Muthukumar-Ravichandran/Smart-locker-/IMG-20250516-WA0002(1).jpg

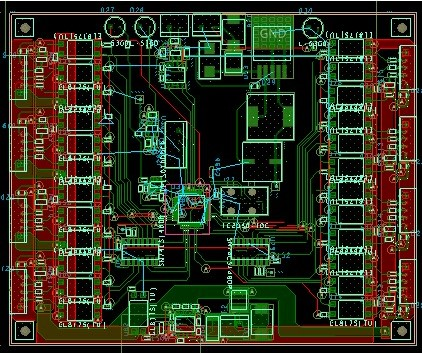
IMG-20250516-WA0002(1).jpg
