Muthukumar-Ravichandran/Smart-locker-/cock_lock.pdf

# STM32

CONTROLLER | 5V TO 3.3V CONVERTER

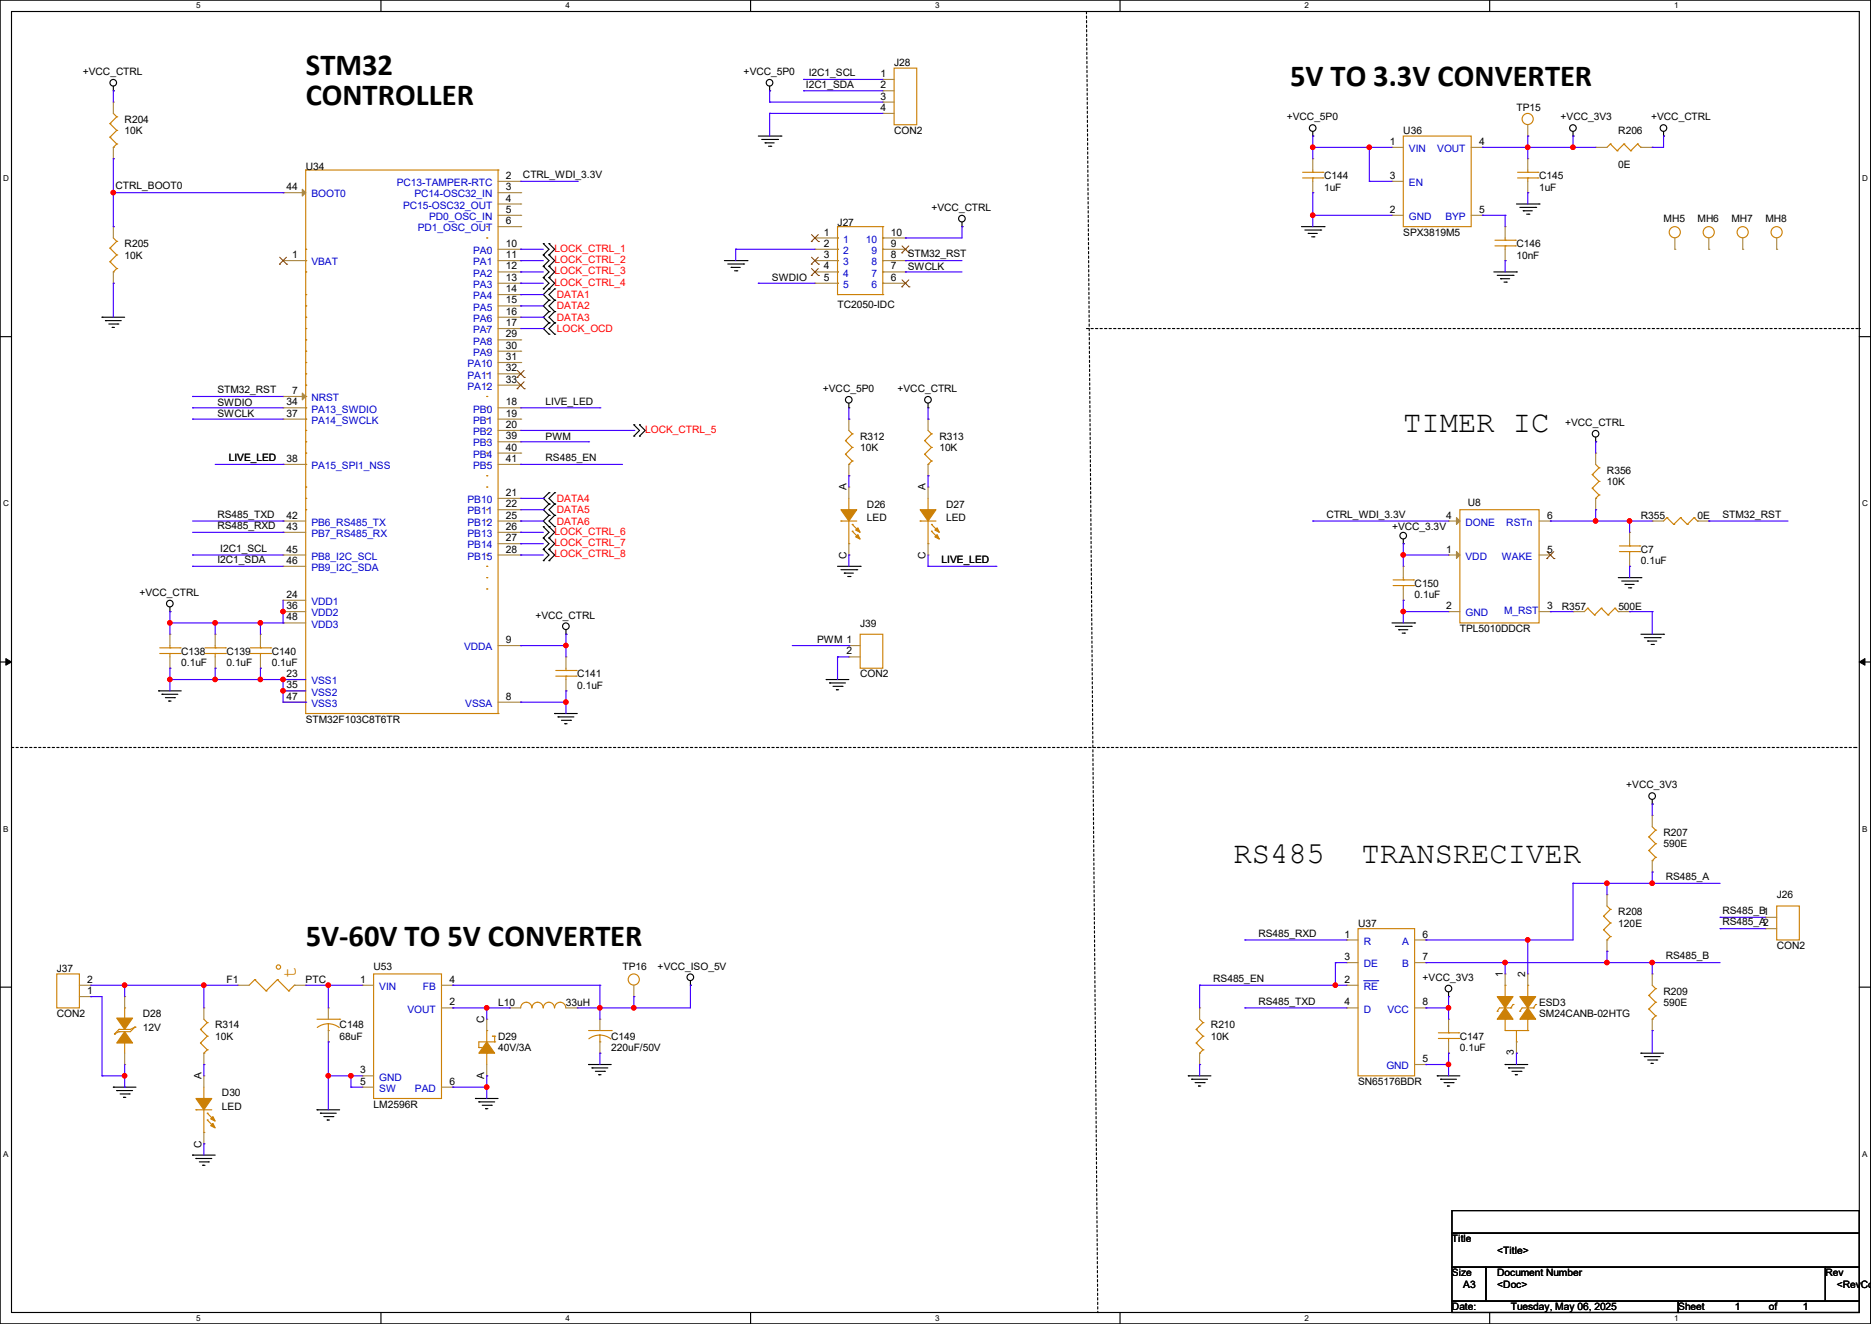
[picture p26: page 1]

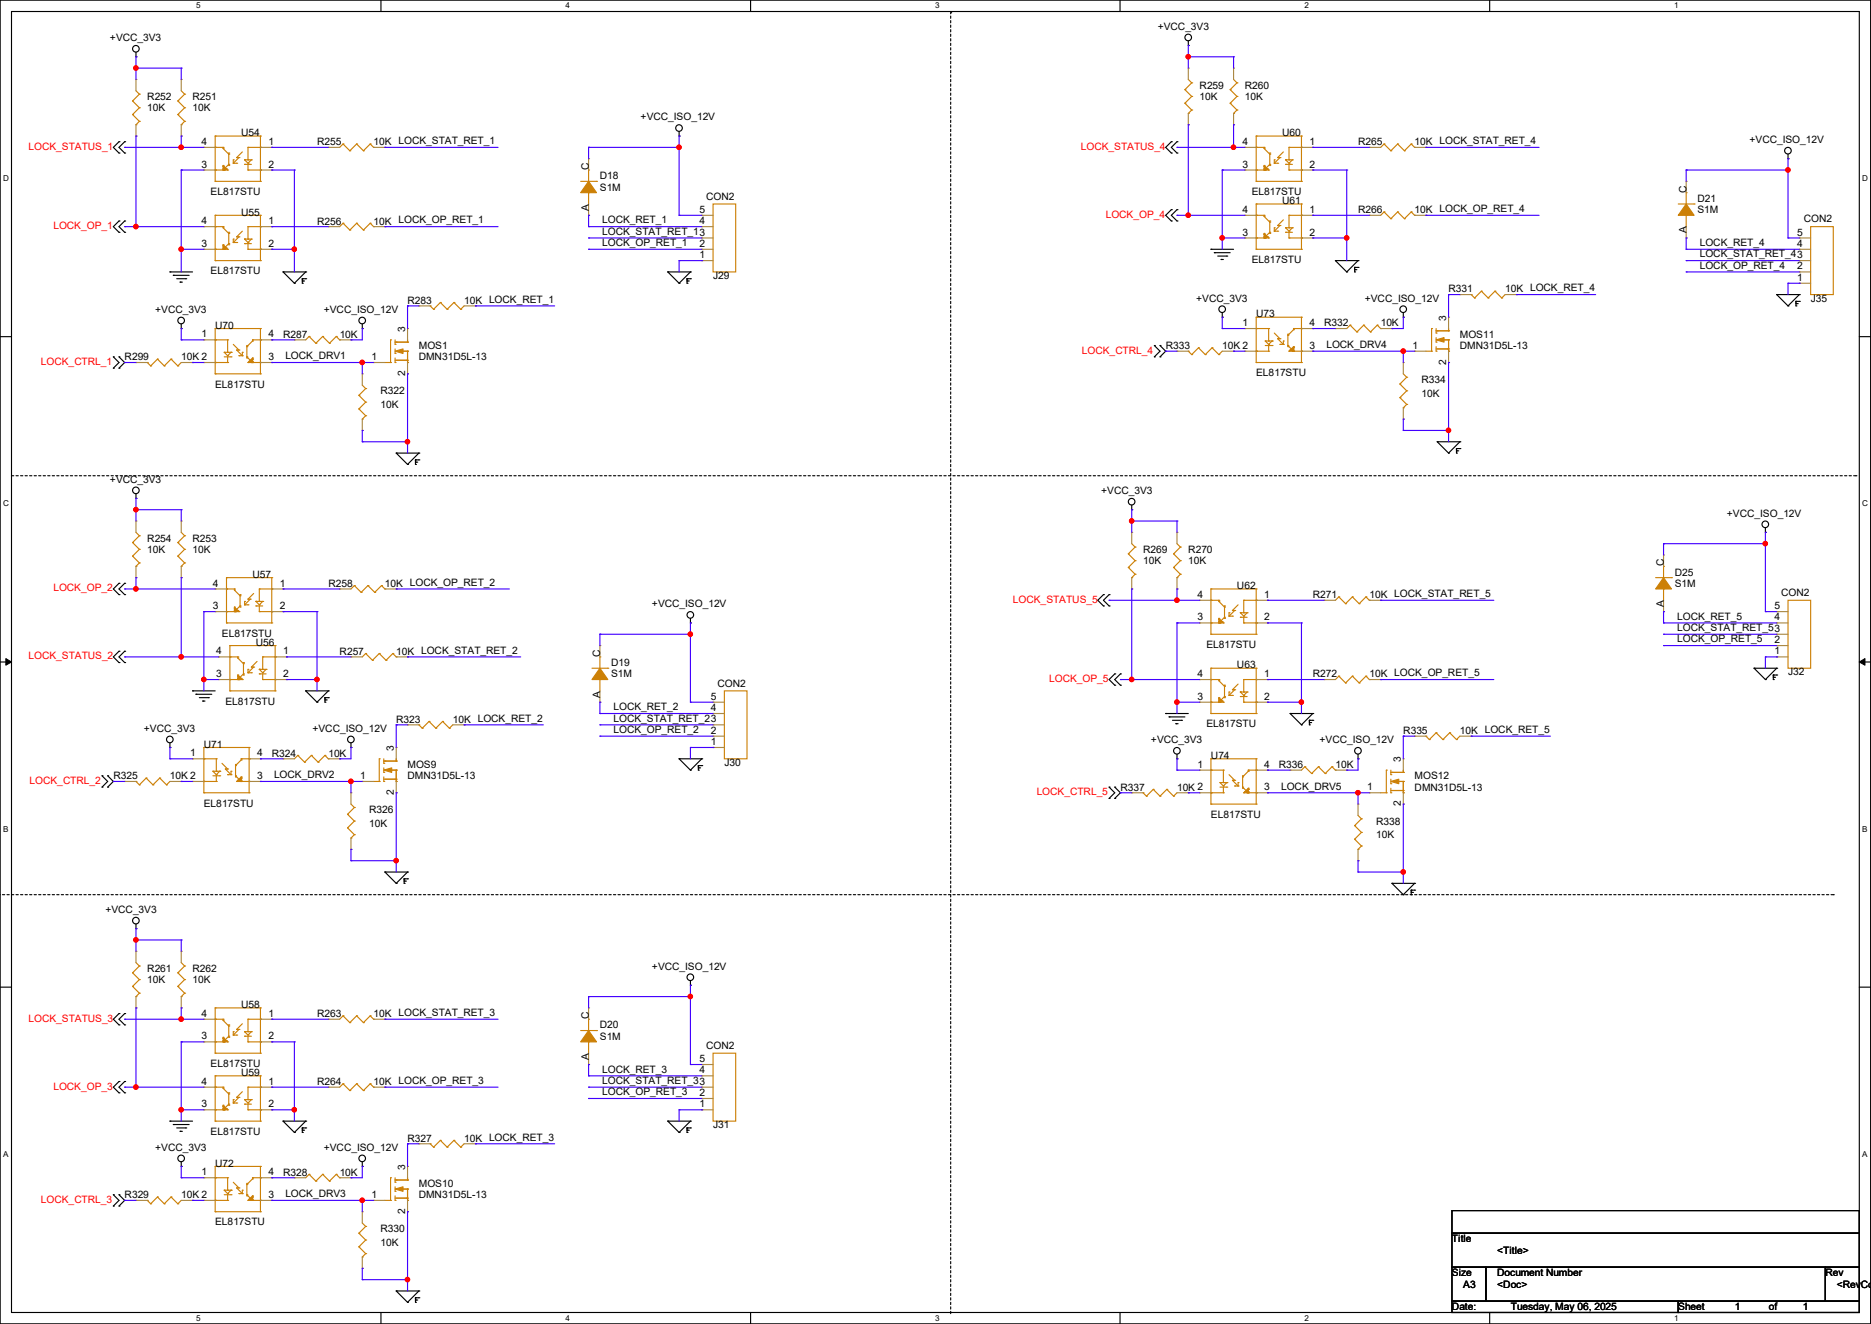
[picture p27: page 2]

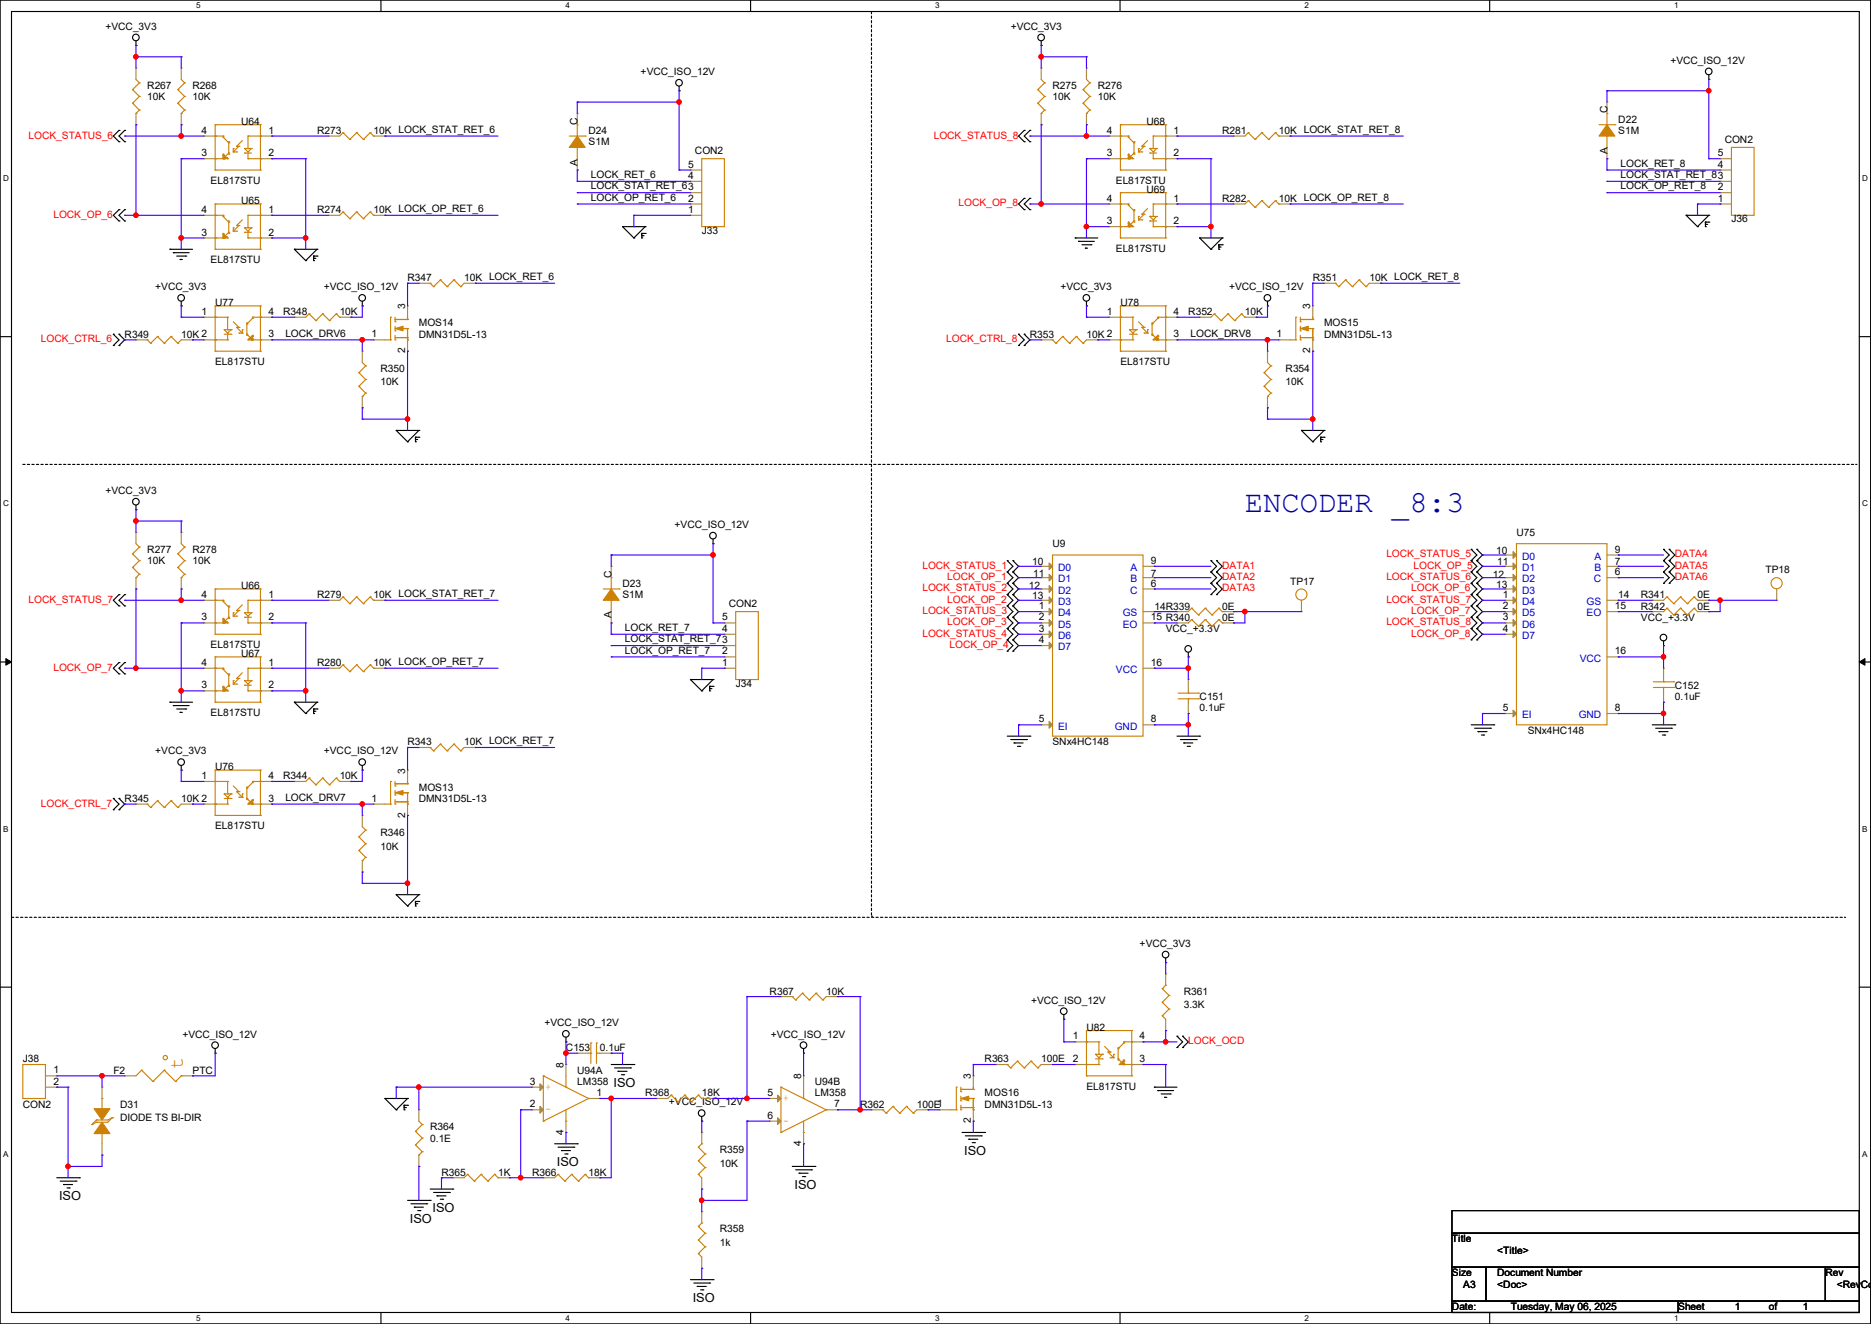
[picture p28: page 3]

DIODE TS BI-DIR
