Muthukumar-Ravichandran/Smart-locker-/(commit log)

2025-07-16 Create Schematic pdf
2025-07-16 Schematic pdf
2025-07-16 Smart locker schematic DSN file
    [VEIP_DLK_CTRL_V00_25APR07_17V2.brd]
2025-07-16 Pcb layout
